Technoburn/ME405_W25_MECHA03/README.md

# README

This repository holds code used by team MECHA03 to complete the ME405 W25 Term Project.

The documentation pages are at https://technoburn.github.io/ME405_W25_MECHA03/

### Hardware Driver Files

* These files are used to interface with hardware peripherals such as sensors and motors.

### Term Project Task Files

* These files are used to implement the multitasking structure of the term project.

### ROMI CAD Files

* These files were used to help design and 3D print hardware layout and mounting.
