Technoburn/ME405_W25_MECHA03/docs/tasks/imu.rst

IMU
===

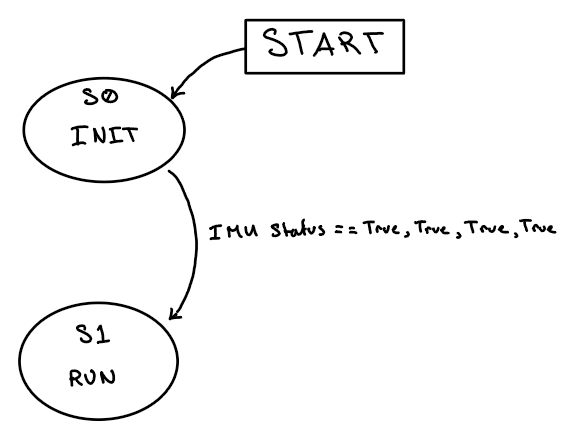
[picture p19: docs/_static/IMUFSM.PNG]
IMU Task Finite-State Machine


.. autoclass:: task_imu.Task_IMU
    :members:
