Technoburn/ME405_W25_MECHA03/docs/tasks/line_sensor.rst

LINE SENSOR
===========

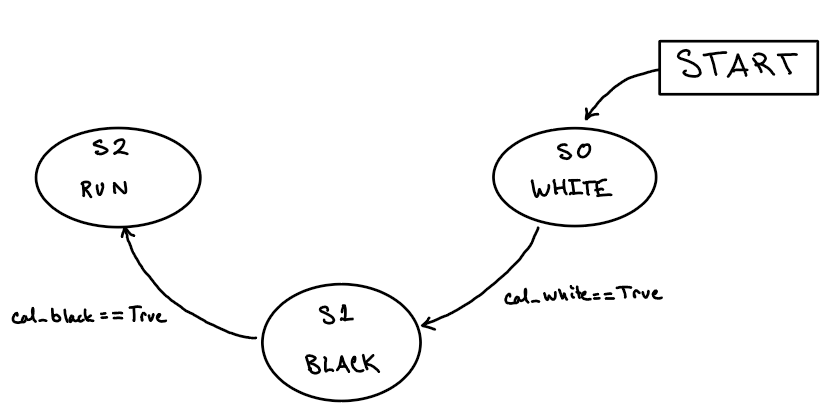
[picture p20: docs/_static/LINEFSM.PNG]
LINE SENSOR Task Finite-State Machine


.. autoclass:: task_line_sensors.Task_Line_Sensor
    :members:
