Technoburn/ME405_W25_MECHA03/docs/tasks/motor.rst

MOTOR
=====

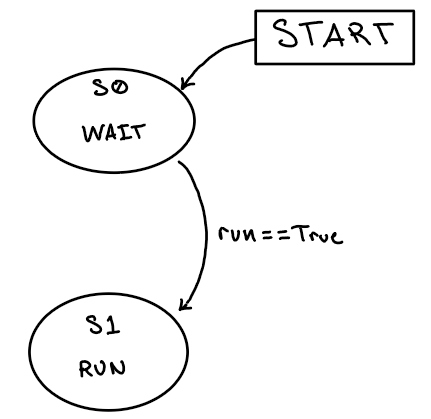
[picture p21: docs/_static/MOTORFSM.PNG]
MOTOR Task Finite-State Machine


.. autoclass:: task_motor.Task_Motor
    :members:
