Technoburn/ME405_W25_MECHA03/docs/drivers/index.rst

Hardware Drivers
================

Custom python classes for interfacing with hardware peripherals like buttons,
sensors, and motors.

Contents
--------

.. toctree::

    boot
    buttons
    controller
    encoder
    imu
    line_sensor
    motor
    path
    voltage
