Technoburn/ME405_W25_MECHA03/docs/drivers/buttons.rst

Buttons
=======

.. autoclass:: button.ButtonSensor
    :members:
    
.. autoclass:: button.ButtonArray
    :members:
