Technoburn/ME405_W25_MECHA03/docs/drivers/encoder.rst

Encoder
=======

.. autoclass:: encoder.Encoder
    :members:
