Technoburn/ME405_W25_MECHA03/docs/drivers/imu.rst

Inertial Measurement Unit
=========================

.. autoclass:: imu.BNO055
    :members:
