Technoburn/ME405_W25_MECHA03/docs/drivers/line_sensor.rst

Line Sensors
============

.. autoclass:: line_sensor.LineSensor
    :members:

.. autoclass:: line_sensor.SensorArray
    :members:
