Technoburn/ME405_W25_MECHA03/docs/drivers/motor.rst

Motor
=====

.. autoclass:: motor.Motor
    :members:
