Technoburn/ME405_W25_MECHA03/docs/drivers/voltage.rst

Voltage
=======

.. autoclass:: voltage.Voltage
    :members:
