Technoburn/ME405_W25_MECHA03/MECHA03 Romi Pinout.xlsx

CN7 Odd Pins |  |  |  | CN7 Even Pins |  |  |  | CN10 Odd Pins |  |  |  | CN10 Even Pins
Pin | Name | Nucleo Function | Component Function | Pin | Name | Nucleo Function | Component Function | Pin | Name | Nucleo Function | Component Function | Pin | Name | Nucleo Function | Component Function
1 | PC10 | USART3_TX | Bluetooth RX | 2 | PC11 | USART3_RX | Bluetooth TX | 1 | PC9 | Digital | R Enable | 2 | PC8 | Tim3/8 Ch3
3 | PC12 | Digital | L Enable | 4 | PD2 | Digital | L Direction | 3 | PB8 | Digital | R Direction | 4 | PC6 | Tim8 Ch1
5 | VDD | Power/Control |  | 6 | E5V | Power/Control | Bluetooth VIN | 5 | PB9 | Tim4 Ch4 | R Effort | 6 | PC5 | Analog In | Line Sensor 9
7 | BOOT0 | Power/Control |  | 8 | GND | Power/Control | Bluetooth Ground | 7 | AVDD | Power/Control | IMU VIN | 8 | U5V | Power/Control
9 | - |  |  | 10 | - |  |  | 9 | GND | Power/Control | IMU Ground | 10 | -
11 | - |  |  | 12 | IOREF | Power/Control |  | 11 | PA5 | User LED | Reserved | 12 | PA12 | USB | Reserved
13 | PA13 | SWD | Reserved | 14 | RESET | Power/Control |  | 13 | PA6 | Analog In | Line Sensor 5 | 14 | PA11 | USB | Reserved
15 | PA14 | SWD | Reserved | 16 | +3.3V | Power/Control |  | 15 | PA7 | Analog In | Line Sensor 7 | 16 | PB12 | Digital | BMP0
17 | PA15 | Tim2 Ch1 |  | 18 | +5V | Power/Control | Line Sensor VCC | 17 | PB6 | Tim4 Ch1 |  | 18 | PB11 | Digital | BMP1
19 | GND | Power/Control |  | 20 | GND | Power/Control | Line Sensor GND | 19 | PC7 | Tim3/8 Ch2 |  | 20 | GND | Power/Control | Right Bumper Ground
21 | PB7 | Tim4 Ch2 | L Effort | 22 | GND | Power/Control | Motor Ground | 21 | PA9 | Tim1 Ch2 | ERA | 22 | PB2 | Digital | BMP2
23 | PC13 | User Button | Reserved | 24 | VIN | Power/Control | ~7.2 V | 23 | PA8 | Tim1 Ch1 | ERB | 24 | PB1 | Analog In | Battery Voltage
25 | PC14 | RTC | Reserved | 26 | - |  |  | 25 | PB10 | Tim2 Ch3 | BMP5 | 26 | PB15 | Digital | IMU RESET
27 | PC15 | RTC | Reserved | 28 | PA0 | Analog In | Line Sensor 3 | 27 | PB4 | Tim3 Ch1 | ELB | 28 | PB14 | I2C SDA | IMU SCL
29 | PH0 | Digital | Line Sensor CNTRL | 30 | PA1 | Analog In | Line Sensor 1 | 29 | PB5 | Tim3 Ch2 | ELA | 30 | PB13 | I2C SCL | IMU SDA
31 | PH1 | Digital |  | 32 | PA4 | Analog In/Out | Line Sensor 12 | 31 | PB3 | Tim2 Ch2 | BMP4 | 32 | AGND | Power/Control | Left Bumper Ground
33 | VBAT | Power/Control |  | 34 | PB0 | Analog In | Line Sensor 10 | 33 | PA10 | Tim1 Ch3 | BMP3 | 34 | PC4 | Analog In | Line Sensor 11
35 | PC2 | Analog In | Line Sensor 2 | 36 | PC1 or PB9 | Analog In | Line Sensor 8 | 35 | PA2 | UART2 | Reserved | 36 | -
37 | PC3 | Analog In | Line Sensor 4 | 38 | PC0 or PB8 | Analog In | Line Sensor 6 | 37 | PA3 | UART2 | Reserved | 38 | -
