Technoburn/ME405_W25_MECHA03/docs/tasks/bump.rst

BUMP
====

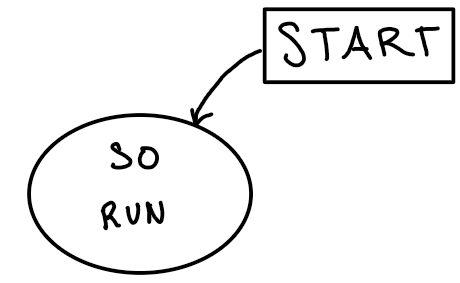
[picture p23: docs/_static/BUMPFSM.PNG]
BUMP Task Finite-State Machine


.. autoclass:: task_button.Task_Button
    :members:
