Technoburn/ME405_W25_MECHA03/docs/tasks/course.rst

COURSE
======

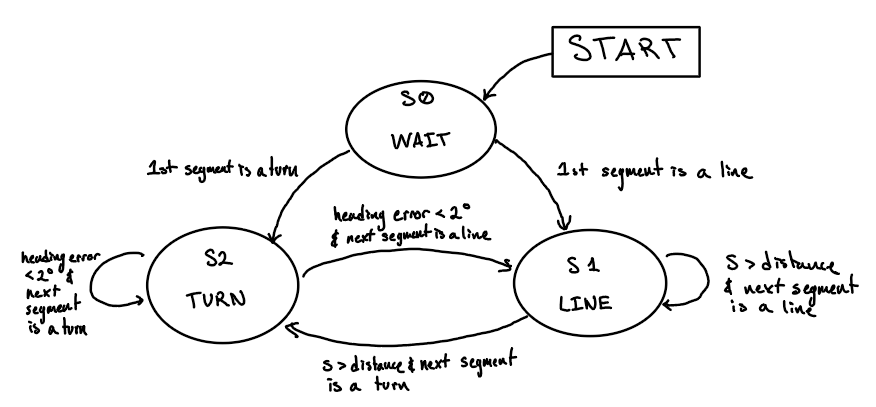
[picture p24: docs/_static/COURSEFSM.PNG]
COURSE Task Finite-State Machine


.. autoclass:: task_course.Task_Course
    :members:
