Technoburn/ME405_W25_MECHA03/docs/tasks/repl.rst

REPL
====

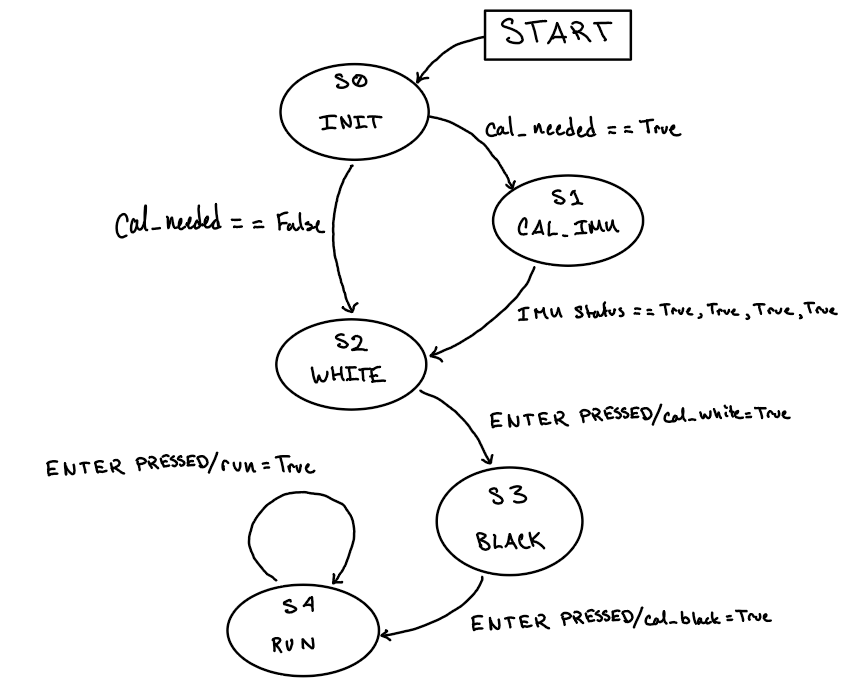
[picture p25: docs/_static/REPLFSM.PNG]
REPL Task Finite-State Machine


.. autoclass:: task_repl.Task_Repl
    :members:
