Technoburn/ME405_W25_MECHA03/Romi 3D Files/qtr-qtrx-models/qtrx-md-03x.step

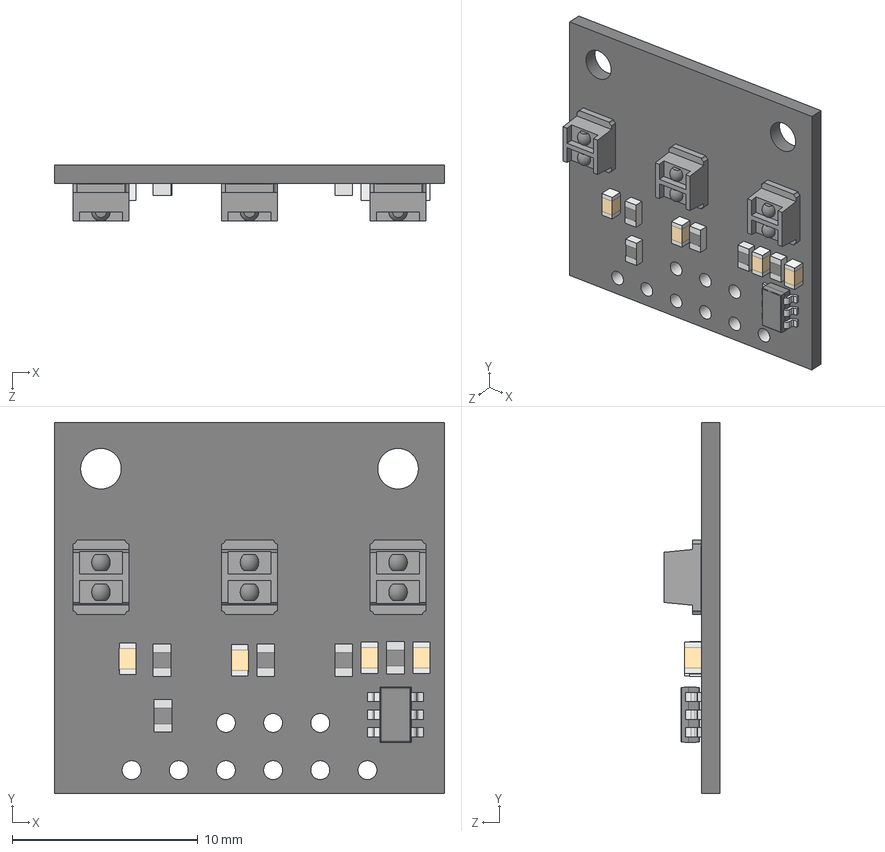
[picture p26: CAD file, 2025-03-16]
Romi 3D Files/qtr-qtrx-models/qtrx-md-03x.step
21.0 x 20.0 x 3.04 mm
