Technoburn/ME405_W25_MECHA03/Romi 3D Files/Sensor Array Connector.SLDPRT

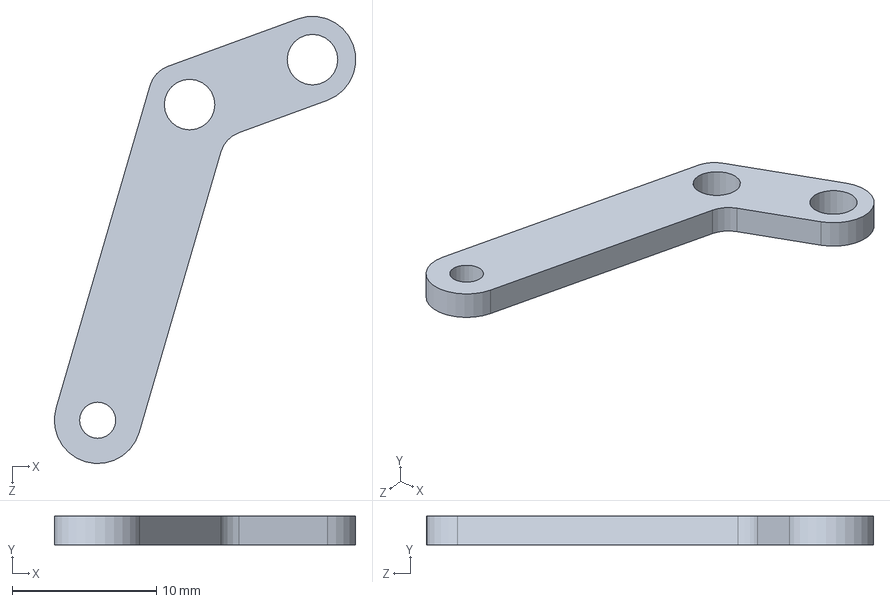
[picture p27: CAD file, 2025-03-16]
Romi 3D Files/Sensor Array Connector.SLDPRT
20.9 x 2.00 x 30.9 mm
