Technoburn/ME405_W25_MECHA03/Romi 3D Files/5x12mmStandoff.SLDPRT

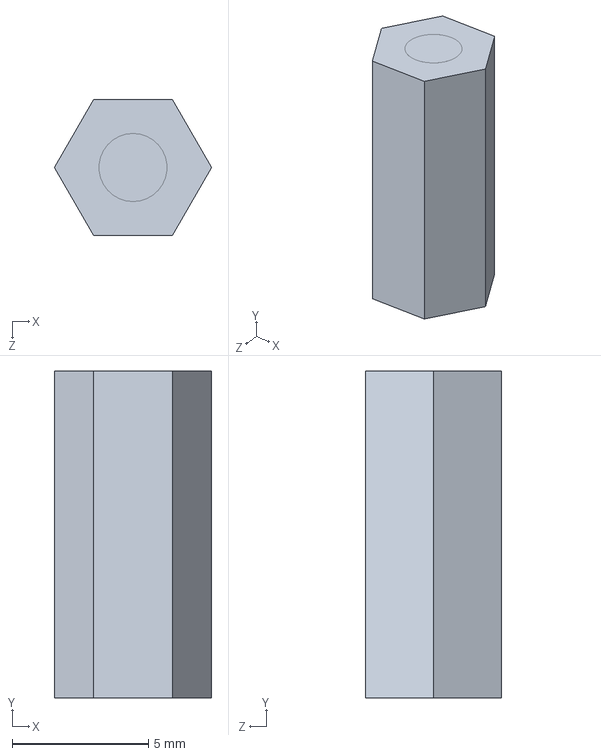
[picture p28: CAD file, 2025-03-16]
Romi 3D Files/5x12mmStandoff.SLDPRT
5.77 x 12.0 x 5.00 mm
