Technoburn/ME405_W25_MECHA03/Romi 3D Files/qtr-qtrx-models/qtrx-md-01x.step

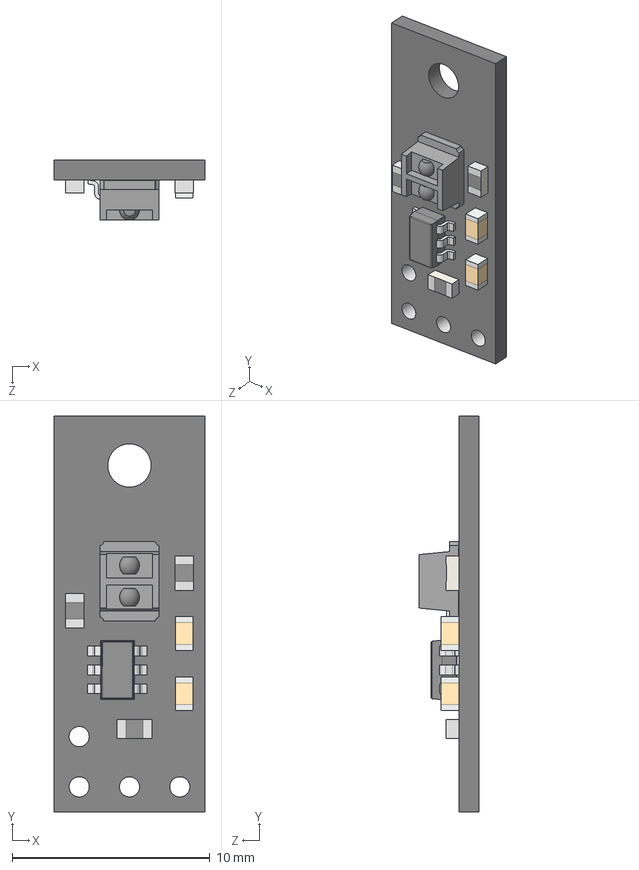
[picture p29: CAD file, 2025-03-16]
Romi 3D Files/qtr-qtrx-models/qtrx-md-01x.step
7.62 x 20.0 x 3.04 mm
