Technoburn/ME405_W25_MECHA03/Romi 3D Files/11x2 Pin Connector.SLDPRT

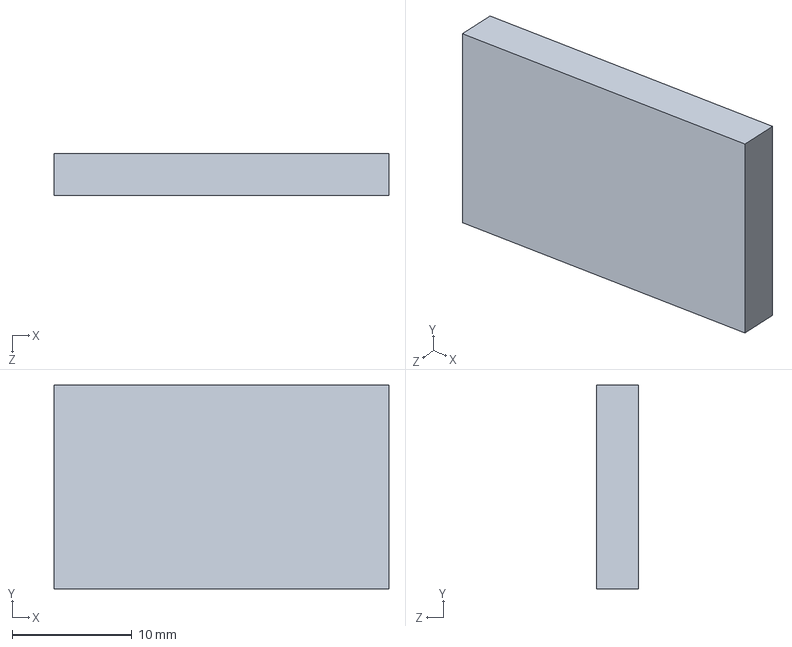
[picture p30: CAD file, 2025-03-16]
Romi 3D Files/11x2 Pin Connector.SLDPRT
27.9 x 17.0 x 3.50 mm
