Technoburn/ME405_W25_MECHA03/Romi 3D Files/5x8mmStandoff.SLDPRT

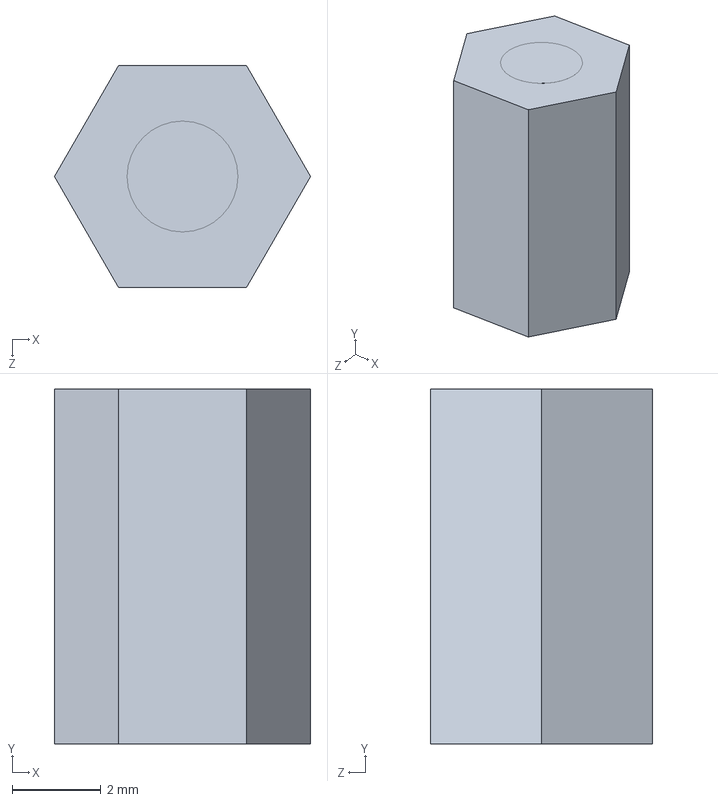
[picture p32: CAD file, 2025-03-16]
Romi 3D Files/5x8mmStandoff.SLDPRT
5.77 x 8.00 x 5.00 mm
