Technoburn/ME405_W25_MECHA03/Romi 3D Files/qtr-qtrx-models/qtr-hd-03x.step

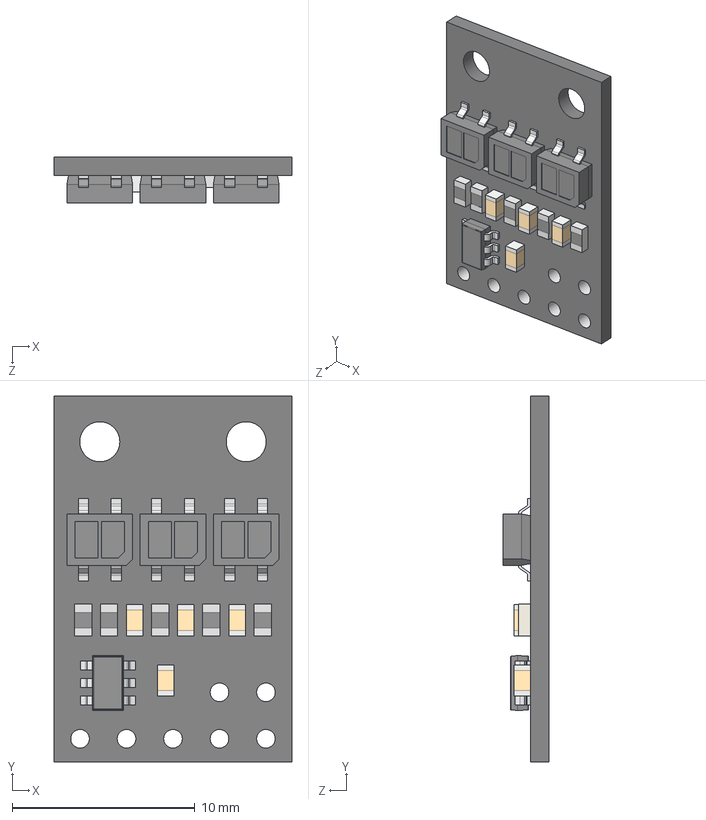
[picture p34: CAD file, 2025-03-16]
Romi 3D Files/qtr-qtrx-models/qtr-hd-03x.step
13.0 x 20.0 x 2.52 mm
