Technoburn/ME405_W25_MECHA03/Romi 3D Files/qtr-qtrx-models/qtr-hd-04x.step

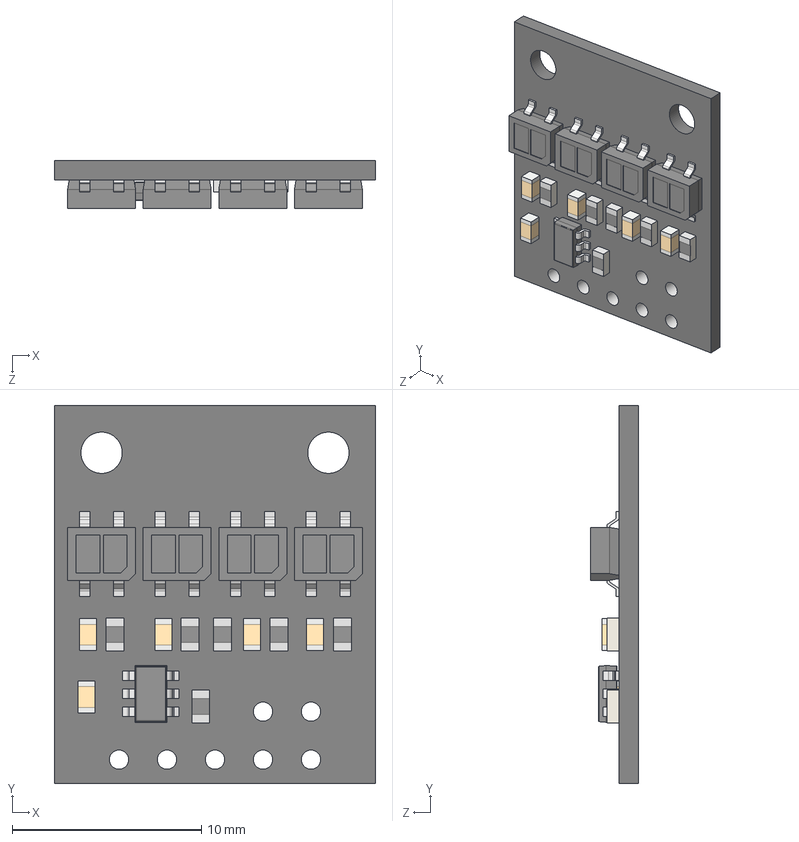
[picture p35: CAD file, 2025-03-16]
Romi 3D Files/qtr-qtrx-models/qtr-hd-04x.step
17.0 x 20.0 x 2.52 mm
