Technoburn/ME405_W25_MECHA03/Romi 3D Files/qtr-qtrx-models/qtrx-md-02x.step

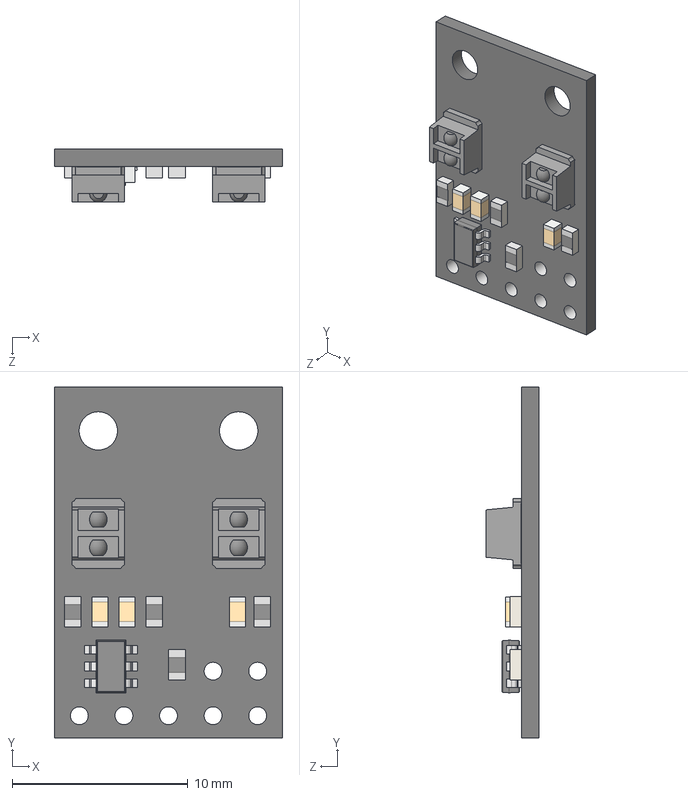
[picture p36: CAD file, 2025-03-16]
Romi 3D Files/qtr-qtrx-models/qtrx-md-02x.step
13.0 x 20.0 x 3.04 mm
