Technoburn/ME405_W25_MECHA03/Romi 3D Files/qtr-qtrx-models/qtrx-md-04x.step

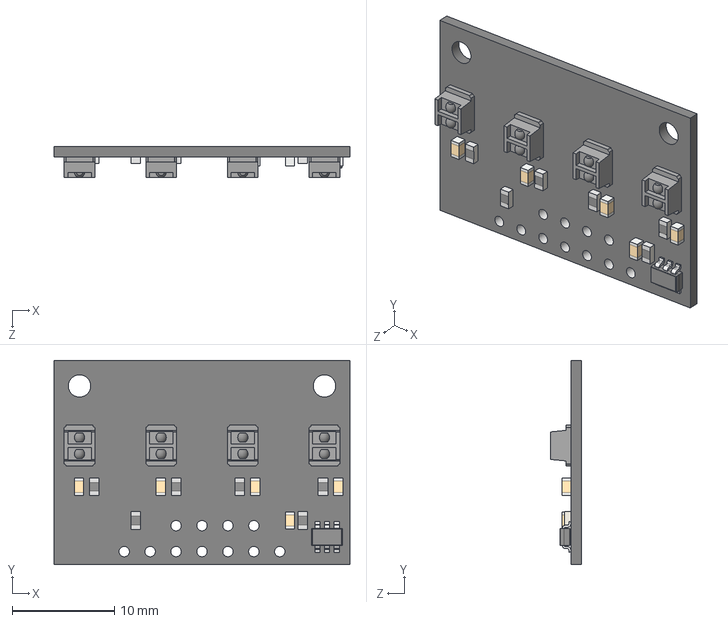
[picture p38: CAD file, 2025-03-16]
Romi 3D Files/qtr-qtrx-models/qtrx-md-04x.step
29.0 x 20.0 x 3.04 mm
