Technoburn/ME405_W25_MECHA03/Romi 3D Files/qtr-qtrx-models/qtr-md-04x.step

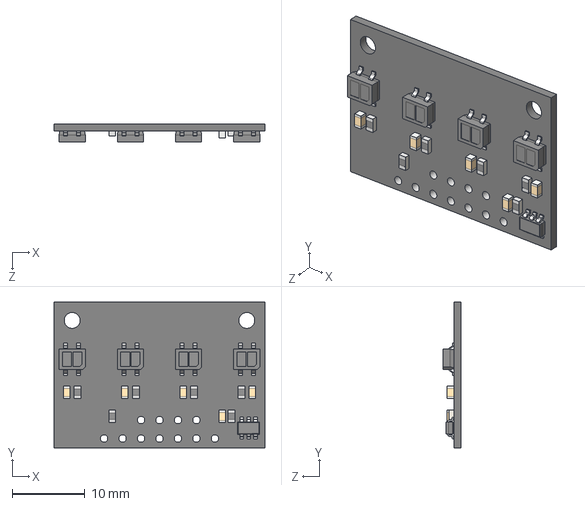
[picture p40: CAD file, 2025-03-16]
Romi 3D Files/qtr-qtrx-models/qtr-md-04x.step
29.0 x 20.0 x 2.52 mm
