Technoburn/ME405_W25_MECHA03/Romi 3D Files/qtr-qtrx-models/qtrx-hd-01x.step

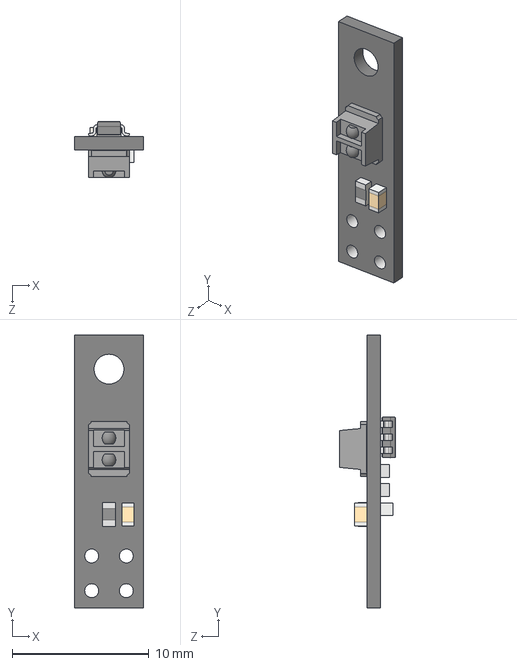
[picture p42: CAD file, 2025-03-16]
Romi 3D Files/qtr-qtrx-models/qtrx-hd-01x.step
5.08 x 20.0 x 4.14 mm
