Technoburn/ME405_W25_MECHA03/Romi 3D Files/qtr-qtrx-models/qtr-md-01x.step

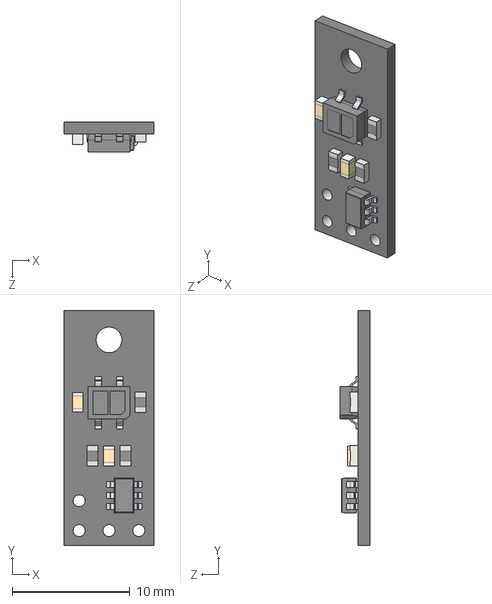
[picture p44: CAD file, 2025-03-16]
Romi 3D Files/qtr-qtrx-models/qtr-md-01x.step
7.62 x 20.0 x 2.52 mm
