Technoburn/ME405_W25_MECHA03/(list of files, cad)

Other CAD files:
Term Project/GameTrack.SLDPRT
