Technoburn/ME405_W25_MECHA03/(commit log)

2025-03-17 Added game track pic
2025-03-17 Added game track picture png
2025-03-17 fixed game track pic
2025-03-17 made game track image fill 100%
2025-03-17 remade html to include 100% game track pic
2025-03-17 Added FSM diagrams to line,motor,repl,imu
2025-03-17 Added IMU fsm diagram
2025-03-17 Inserted Hardware Photos
2025-03-17 Update Voltage DIvider Equ
2025-03-17 Voltage Typo
2025-03-17 Add motor plots
