Technoburn/ME405_W25_MECHA03/docs/_static/BT.jpg

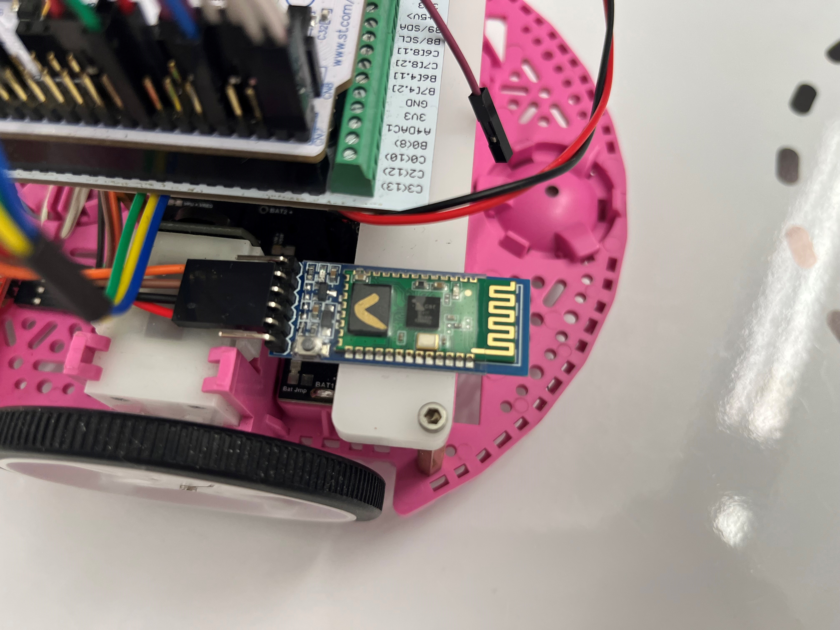
[picture p13: docs/_static/BT.jpg]
docs/_static/BT.jpg
